AaaYi143/FPGA-Competition-Neural-Network-particle-recognition-system/stm32/verification/ui_class1_90pct.png

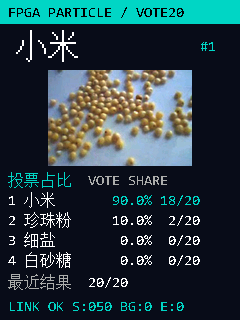
stm32/verification/ui_class1_90pct.png
