AaaYi143/FPGA-Competition-Neural-Network-particle-recognition-system/docs/视频画面参考图/ref_08_pipeline_averaging.png

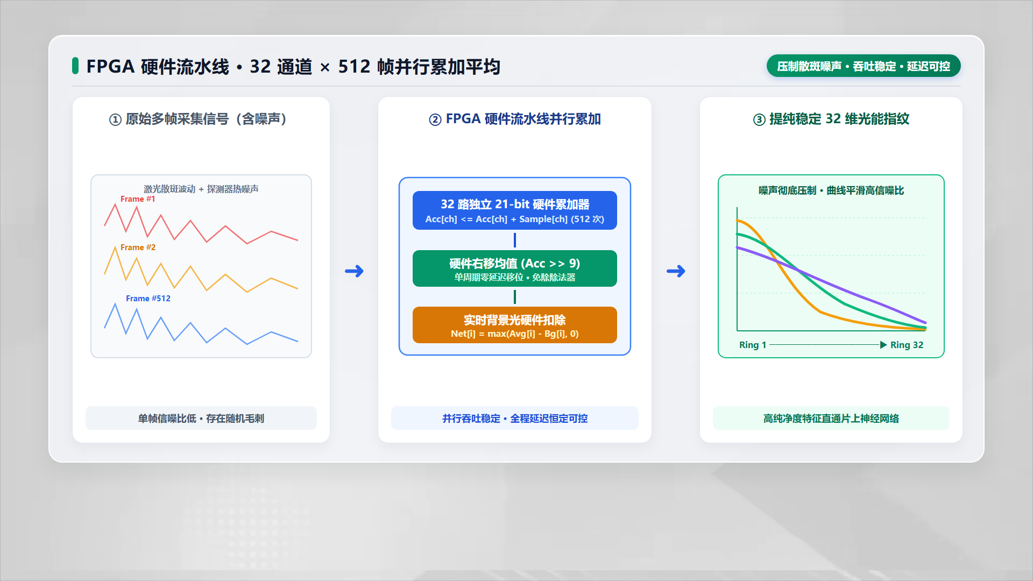
docs/视频画面参考图/ref_08_pipeline_averaging.png
