AaaYi143/FPGA-Competition-Neural-Network-particle-recognition-system/docs/design-review.md

# FPGA 激光粒度仪实施分析

截至 2026 年 9 月 7 日，已确认开发板为野火升腾 Pro XC7A100T。当前可以先完成数字采集与离线分析；老师选用的 ADC 型号、完整帧率指标、探测器实物针脚和光学标定还未提供，因此本工程当前是可验证的采集基础，尚不是可下载即测粒径的整机固件。

## 一 你现在可以承担的工作

| 工作 | 你能交付什么 | 本轮进展 | 仍需实物或老师提供 |
|---|---|---|---|
| 系统指标与分工 | 完整帧率、每环样本数、误差、延时的定义 | 本文和速率计算工具 | 明确“上万次”的单位和目标精度 |
| FPGA 扫描控制 | 4 地址线和 2 EN、互锁、稳定等待 | 已实现 | 测试点确认控制与模拟建立时间 |
| 数据组织 | 丢弃初始样本、平均、32通道快照、时间戳 | 已实现 | ADC实际位宽、数据编码 |
| ADC 驱动 | 开始转换、读回有效结果、时序约束 | 已定义适配接口 | 芯片完整型号、模块原理图与接线 |
| 上传与显示 | 正确传输整帧、画光强和粒度分布 | 离线CSV分析已实现；传输待接入 | 目标带宽、选以太网或其他出口 |
| 粒径算法 | 标定、非负正则反演、D10/D50/D90 | 算法可运行，未提供物理核 | 光学参数与标准样品实测 |
| 边缘智能 | 小模型快速估计、异常识别、质量分数 | 路线明确，未训练或部署 | 标注数据、边缘设备、误差验收标准 |
| 比赛证据 | 波形、帧率、误差和对比实验 | 验收步骤已列出 | 真实仪器测试结果 |

你最适合先把“FPGA确定性采集 + 帧数据和时间戳 + 上位机分析”做通。模拟前端、探测器针脚和光路由相关队友/老师确认，双方用明确的电压、带宽和时序接口对接。

## 二 当前设计与旧文档的差异

用户这次描述是：每一路探测器先由运放处理，再接两片 16 选 1，其公共输出进一个 ADC。旧文档描述的是 31 路半环散射探测器共用运放，另有中心透射探测器，共 32 路，且使用 FPGA 内部 XADC。旧代码甚至存在额外通道编号及特殊通道映射，不可直接复制为新硬件的环顺序。

本工程以本次描述为准。仍需要确认是 **32 个散射环**，还是 **31 个散射环 + 1 个中心透射通道**。若实际是 32 个散射环另加中心参考，总数就是 33，当前两个 16 选 1 只能覆盖 32 路，需要增加采样入口。软件默认中心是 ch0 仅沿用旧文档假设；32 路全部是散射环时，必须使用 `--center-channel none`。物理环到芯片输入的映射须逐路验证；代码只保证芯片输入顺序，不保证探测器半径顺序。

环形阵列接收角度分布并进行反演，符合激光衍射/角分辨散射的工作方式。动态光散射还需要光强随时间波动的相关分析，不能仅凭“有布朗运动”就认定为 DLS。竞赛说明应按真实测量原理修订。[激光衍射原理](https://www.malvernpanalytical.com/en/products/technology/light-scattering/laser-diffraction)、[DLS 原理](https://www.malvernpanalytical.com/en/learn/knowledge-center/technical-notes/tn101104dynamiclightscatteringintroduction)。

光路也需画清楚：典型傅里叶接收透镜是在样品散射之后将不同散射角映射到探测器半径；透镜位置不同，角度标定不同。“水珠”若指空气中的液滴，与水中悬浮颗粒的折射率和模型条件并不相同。不要直接沿用旧文档的 690 nm、焦距或 0–100 μm 范围作为实测参数。

## 三 两片模拟开关的正确控制

截图标注为 ADG1206YRUZ。按厂家真值表，EN 高有效，低电平关闭全部开关；A3..A0=0000 选择 S1，1111 选择 S16。[ADG1206 数据手册 第8–9页](https://www.analog.com/media/en/technical-documentation/data-sheets/adg1206_1207.pdf)。

| 状态 | EN1 | EN2 | A3..A0 |
|---|---|---|---|
| 上电、复位、换通道死区、故障 | 0 | 0 | 地址在全关期间更新 |
| 第一片第 k 路 | 1 | 0 | k，范围0至15 |
| 第二片第 k 路 | 0 | 1 | k，范围0至15 |
| 禁止状态 | 1 | 1 | 两路运放可能经开关互相驱动 |

四根线是通道地址线，不是四个独立片选。两片 A0 对 A0、A1 对 A1、A2 对 A2、A3 对 A3 必须实际同网。截图中的 `ADG1_LOGIC0` 和 `ADG2_LOGIC0` 名称不同，仅靠截图不能认定已连接；应统一为 `MUX_A0` 等网络，或在上层原理图明确短接，并检查导出的网表。带总线符号的线也应通过网络高亮/网表核查，不能仅凭外观判断每根支线连通。

两个 EN 应独立由 FPGA 推挽输出。关闭的一片输出明确的 0，不输出 Z。截图中的 4.7 kΩ 下拉方向符合高有效 EN 的上电关闭要求；它在 FPGA 未配置或引脚高阻时兜底。3.3 V 驱动时每根使能线的下拉电流约 0.70 mA。不要给这个型号的 EN 上拉到默认选中，也不要让 FPGA 引脚被外部上拉到 5 V。

换通道顺序：**EN全关 → 等待关断完成 → 更新共用地址 → 地址稳定 → 只开目标EN → 模拟稳定 → ADC新采样 → 丢弃/平均 → 关闭EN**。即便同一片内部有先断后通，也不等于两片芯片之间自动互锁；需要 FPGA 的全关死区。

两片 D 汇合是此架构的前提，但只在严格互斥、允许的模拟电压和充分建立时间下成立。EN 下拉只固定数字控制脚，不会把浮空的 ADC_IN 拉为零。全关期间 ADC_IN 可能保持前一次电压，不能把这段的转换当作有效值。

### 模拟电路需要核对的项目

1. 若传感器输出为光电流，前端需要跨阻放大器，反馈电阻决定 I/V 增益，反馈电容需依据光电二极管结电容与运放稳定性确定。每环先放大能避免反复切换高阻电流节点，但 32 路偏置、噪声、增益差异必须标定。
2. ADG1206 单电源工作范围包含 5 V；主要动态/导通电阻规格是在 +12 V 或双电源条件给出，不能照搬为截图 +5 V 条件下的实际指标。模拟信号要处于供电轨内。若运放用 ±12 V 而可能输出负压或超过 +5 V，必须在进入单电源开关前处理范围，不能仅在 ADC 前分压。[ADG1206 供电与规格条件](https://www.analog.com/media/en/technical-documentation/data-sheets/adg1206_1207.pdf)。
3. 共用输出的导通电阻、布线电容、ADC 采样电容和缓冲器决定建立时间。ADC 前是否需要专用缓冲取决于具体 ADC；不能默认运放可以直接驱动任意 ADC 采样网络。
4. 一阶 RC 在最坏满量程阶跃、半 LSB 误差下，理论建立时间约为 `(B+1)*ln(2)*R*C`：12位约9RC，16位约11.8RC。这只是单极点近似，还需考虑运放压摆率、多极点、开关注入和 ADC 踢回。应交替输入近零和近满量程，实测第几个采样稳定。
5. 每通道模拟滤波应与要保留的光强变化带宽匹配。扫描后共用很低截止频率的滤波器会混合前后通道，延长串扰尾巴；数字平均不能修复已混叠或已削顶的信号。
6. 若最后选 XADC，按其外部模拟输入模式及板卡接线校核范围，不能将 0–5 V 直接接进去；旧文档采用的 0–1 V 方案也须验证分压输出阻抗和采样建立。[AMD XADC 模拟输入](https://docs.amd.com/r/en-US/ug480_7Series_XADC/Analog-Inputs)。
7. 原理图截图未显示完整电源、运放、ADC和传感器连接，不能据此判定PCB可生产。EN拉低、地址默认值、去耦、共地、激光电源噪声与模拟回流都要在完整电路中核对。激光联调应使用封闭光路和终端吸光装置，避免眼睛接触直射及反射光束。

## 四 帧率预算

一帧定义为按已确定映射收集所有 32 路的有效测量值。ADC转换次数、单环更新率、完整帧率和算法输出率必须分别记录。

旧文档每通道 250 μs，整帧 `32*250 μs=8 ms`，约125帧/秒。这是原文参数的计算，不是本项目实测结果。

完整 10000 帧/秒要求每帧100 μs，每路最多3.125 μs。若每路保留N个样本、丢弃D个，粗略预算为：

`Tslot = Tbreak + Taddress + Tsettle + (D+N)/Fs_effective + Tcontrol`

`Fframe <= 1/(32*Tslot + Tframe_handshake + Toutput_stall)`

其中 Fs_effective 必须包括转换、读回及适配器吞吐约束；流水 ADC 的吞吐率和单次延时不能混用。当前核心只允许一个未完成请求，不能直接按流水 ADC 峰值吞吐计算。

| 预算条件 | 不含建立和其他开销的理论上限 |
|---|---|
| 单ADC 1MSPS，每路1个有效样本，无丢弃 | 31250帧/秒 |
| 单ADC 1MSPS，每路1有效+1丢弃 | 15625帧/秒 |
| 单ADC 1MSPS，每路4有效+1丢弃 | 6250帧/秒 |
| 单ADC 1MSPS，每路128有效，无丢弃 | 244.14帧/秒 |

XADC包含双12位1MSPS ADC，但当前两片开关并成一个模拟节点，并不能把同一单路扫描简单当作2MSPS。平均128次和完整1万帧/秒不可能在单路1MSPS条件下同时成立。[AMD XADC 概述](https://docs.amd.com/r/en-US/ug480_7Series_XADC/XADC-Overview)。

示例假设：死区0.2 μs、地址0.04 μs、建立1 μs、控制0.1 μs、1MSPS、1有效+1丢弃，则每路3.34 μs，约9356帧/秒，尚未包含输出停顿。这不是器件推荐参数或实测结果。使用 `tools/rate_budget.py` 替换参数即可重新算。

32路是顺序采样，并非同时采样。在1万帧/秒且均匀扫描时，首尾两环测量时间相差约96.875 μs。若液滴/颗粒运动比这更快，同一帧可能拼接不同状态；需要同时采样保持、多ADC并行或降低被测动态范围。FPGA流水处理不会消除这个时间偏差。

当前RTL默认参数偏保守：50MHz下死区10拍=0.2μs、地址2拍=0.04μs、稳定100拍=2μs、丢弃1次、有效1次。它们是联调起点，不保证1万帧/秒；确认实际建立时间后再调整。

### 传输带宽

按每通道16位，原始32环载荷64字节，1万帧/秒为640kB/s。若**计划**每帧增加24字节应用头和CRC，总88字节，需要880kB/s，即7.04Mbit/s应用数据；UART 8N1理论至少8.8Mbaud，还未计其他余量。115200串口最多约130.9帧/秒（88字节/帧），921600最多约1047.3帧/秒。

板载CH340是串口桥；不能把USB连接器等同于USB高速FIFO。野火Pro已有RTL8211F千兆网口，适合评估UDP分批传多帧。后续帧协议建议明确magic/version、序号、时间戳、ADC码宽、状态、饱和位图、载荷长度和CRC。UDP要记录序号缺口、乱序和溢出，不能只看界面刷新快。[本地野火规格书 第37–38、45页](<D:/vvd/A盘（资料盘）/[野火]升腾_Pro开发板硬件规格书V1.0.1.pdf>)。

当前核心为单帧握手缓冲，`frame_valid && frame_ready` 才算下游接收；等下游时不会覆盖这一帧，但会暂停开始下一帧，并累计 `stall_cycles`。因此目前不承诺采集与上传完全重叠。后续高速版应接入整帧FIFO/乒乓缓存与跨时钟FIFO，并按容量定义满时策略及丢帧计数；有限缓存不能解决长期带宽不足。

## 五 当前代码接口

`rtl/ring_scan_core.sv` 所有普通输入必须与clk同步，rst_n异步有效，实际顶层须同步释放；ADC适配器与核心一起复位。run拉低时完成当前帧再停，若要立即中断使用复位。超时进入锁定故障，EN全关，避免迟到转换进入下一环；复位前须清空ADC驱动的待完成事务。

ADC协议：`adc_req && adc_ready` 表示适配器接受一次**新的采集**，不能仅表示旧结果可读。之后至少隔一个clk边沿，用 `adc_valid` 和 `adc_data` 返回对应结果；仅一笔未完成请求。跨域多位数据用握手/FIFO，不可分别加两级同步器。

- SAR/SPI ADC：请求触发规定的CNV/CS操作，采集/转换/移位遵照型号时序，结果校正为无符号码后返回。
- 自由运行并行ADC：驱动必须清除或计数切换前已有流水样本，确定返回的是请求后的模拟输入。随便把ADC数据直接连入 `adc_valid` 会产生串环。
- XADC：需配置对应外部通道和工作模式，结合EOC与DRP的DRDY/DO读取；不能把EOC当作数据总线已有效。事件采样和连续采样的适配方式不同。当前未生成这个具体驱动。

平均按2的幂次样本数，向下截断，累加位宽随平均次数增长。`frame_data[ch*ADC_BITS +: ADC_BITS]`是该通道平均值；仅在frame_valid时整帧有效。通道0..15是第一片S1..S16，16..31是第二片S1..S16。`frame_timestamp`为开始扫描第一通道前的核心时钟计数，单位是clk周期，非UTC，也不是32路同时采样时刻；上电复位清零。`frame_id`从0开始每完成帧加1，32位自然回绕。

`frame_saturation`逐位记录保留样本出现全1码；丢弃样本不计入。此检测针对适配后无符号直二进制正满量程，不是通用的模拟削顶检测，无法检测运放提前饱和或负端削顶。默认ADC_BITS=16仅是接口占位参数；实际12位ADC应设置12并正确截取数据，而非把12位码零扩展后仍用16位满量程阈值。

## 六 反演和边缘模型怎么做

先拿可靠数据：遮光暗场 → 空白介质背景 → 已知光强/电压下的逐路增益 → 标准粒径样品验证。暗场和空白背景是不同来源的基线，最终用于程序的dark数组应匹配本次实验的校准策略。gain是校正系数，不是直接填运放增益；不同跨阻电阻应折算到一致的光强/光电流单位。必要时实测串扰矩阵，不能仅用逐路gain掩盖跨通道耦合。

物理反演需每环内外径、有效面积/角覆盖率、焦距、探测器位置、波长、介质及粒子折射率。近似theta=arctan(r/f)仅在相应光学布置成立；半环需实际角面积积分。Mie计算要将角分布按各环面积/收集立体角积分为核K，并用标准样品验证。水珠、气泡和固体颗粒不能自动共用同一核。

已实现的数值基线：先做 `y=max(raw-dark,0)*gain`，排除已确认的中心透射通道，再求 `min(x>=0) ||Kx-y||² + λ||x||²`。K必须采用与校正数据一致的单位，且列表示单位颗粒体积分数的响应；程序要求显式声明 `--kernel-basis volume_fraction`。把任意强度权重当体积分数，会导致D值含义错误。K来自外部标定或经验证的物理建模，本项目没有凭空提供K。

输出体积分布和按累积体积分数首次达到10%、50%、90%的粒径中心D10/D50/D90，离散分位受箱宽限制。残差是拟合一致性指标，不等于可信概率；低残差也不保证逆问题唯一或模型正确。32路信息不能任意支撑成百个独立粒径自由度，粒径箱数和正则强度需验证。零散射不给有效粒径；缺失核只输出光强。无信号阈值、异常残差阈值需通过真实噪声数据标定。

透射通道可以在参考强度I0存在时计算透射率/消光度，但绝对浓度还依赖光程、粒径与消光模型，不能直接把中心电压写成浓度。当前没有宣称完成浓度计量。

边缘路线建议分两层：FPGA做确定时序、统计和可量化的小模型计算；有CPU/NPU的边缘设备承担模型训练后推理或实验说明。XC7A100T是Artix-7 FPGA，不是带ARM处理系统的Zynq。大型语言模型适合低频解释、实验指导，不宜成为每一帧必须等待的闭环。

可落地的竞赛增强是用经标定的散射向量训练小MLP/查表回归，预测少量分布系数或D值，同时输出异常指标；先与上述物理基线比较，再做量化与定点误差验证。按样品批次/采集日期划分训练和测试，不能把同一段连续记录随机拆分而形成数据泄漏。测试需涵盖未见粒径、不同浓度、光源变化、气泡、污损和饱和；越界拒绝输出。没有训练数据、模型权重与独立评估时，不能说已经实现了边缘AI测量。

## 七 上板与比赛验证顺序

1. **针脚与电压**：老师确认ADC及模块原理图，测量逻辑供电、模拟输入范围、共地；核对探测器究竟是10×2还是20×2、2.0mm间距、1脚方向及各环/公共端。截图聊天对针数有矛盾，不可据此下单封装。
2. **只测数字控制**：逻辑分析仪看4地址+2EN，检查0..31循环、15→16和31→0、上电及复位关闭、任何时刻无双EN；实测死区。
3. **单ADC固定电压**：确认输入编码、零点、满量程、噪声、采样频率和读取延时；核对驱动无半字/错边沿问题。
4. **32路电压替代探测器**：各路给可区分电压，检查通道顺序，重点测试相邻0/接近满量程跳变；改变等待和丢弃次数，找满足误差预算的最短建立时间。
5. **真实暗场和空白**：记录多帧均值/标准差、工频噪声、饱和位图、各通道增益、光源漂移；报告每通道噪声而非只展示平滑曲线。
6. **完整采集上传**：记录帧号、时间戳、帧间隔分布、持续吞吐、背压/溢出、丢包。停止/重启、拔插接收端、ADC不返回都要能检测；当前数字故障逻辑已有仿真覆盖，上板仍要测。
7. **标准粒径样品**：不同已知粒径、浓度、重复测量与独立参考仪器对比，报告相对误差、重复性、有效测量范围和失败条件。不得把合成测试当实测性能图。
8. **模型对比**：同一测试集比较物理反演与模型的误差、每帧延时、持续吞吐、资源和功耗；展示异常拒绝。屏幕刷新率与内部测量帧率分开展示。

## 八 资料位置与后续对接清单

- 板卡规格书：[野火升腾Pro V1.0.1](<D:/vvd/A盘（资料盘）/[野火]升腾_Pro开发板硬件规格书V1.0.1.pdf>)，第8–9页器件，第16页时钟，第47页复位，第53–54页扩展。
- 器件 `xc7a100tfgg484-2`，50MHz时钟W19，RESET=N15。建议CN3物理5..10接A0..A3、EN1、EN2，对应Y16、AA16、AA15、AB15、U15、V15；这只是建议接线，见非激活的约束示例。
- 资料目录有AD9280/AD9708模块及 `20.dig_volt`，只是参考，不代表老师选了AD9280。
- 百/千兆以太网参考 `D:/vvd/Pro/ebf_xc7a100t_pro/ebf_xc7a100t_pro_tutorial_code_20211220/43.eth_udp_loop/`。集成时处理IP依赖、时钟域、FIFO、帧边界和网络可靠性。
- 旧 `D:/vvd/shijue/xdc/pin_constraints.xdc` 存在 `!!INVALID!!`、`!!FIXME!!` 和与正式资料冲突的时钟引脚，不应直接套用。

后续一次补充这些内容即可继续：ADC完整型号/模块正反面及原理图、接口电压和针脚；老师对完整帧率与精度的原话；探测器针脚/32通道定义；运放型号与反馈RC、输出电压范围；光学参数与标准样品；边缘计算设备。当前不等待这些信息来阻塞可独立完成的代码，但这些缺项决定了上板、真实粒径和边缘模型的最终验收。
