AaaYi143/FPGA-Competition-Neural-Network-particle-recognition-system/docs/packaging-adc-precision-review.md

# 结构、ADS8681 与电阻容差评估（2026-09-09）

本次依据用户传感器正反面照片、此前原理图截图，以及 ADS8681 官方数据手册。照片不能确定针脚定义、精确尺寸、中心探测器接法和结电容；淘宝短链未能读取，尚未验证商品模块的原理图、接口和实际性能。

## 结构决定

优先采用传感器背面直接对插的一块四层模拟前端板，板面尽量平行。通过匹配的 2.0 mm 短排母连接，使用安装孔和绝缘支柱承力，避让背面中央凸起器件，不遮挡正面光路。排针间距并不能替代排数、两组插座相对坐标和高度的实测。

| 方案 | 评价 | 使用条件 |
|---|---|---|
| 单块四层前端板 | 首选；可以把每路跨阻放大器紧靠传感器接口，调试和散热容易 | 面积允许，双面器件避让连接器和支柱 |
| 90° 运放子板 | 可以实现，但拐角连接不是屏蔽，会增加机械悬臂和连接寄生 | 若用于原始光电流，首级运放必须仍靠近连接器；更适合传送放大后的低阻输出 |
| 两三层运放板堆叠 | 暂不优先；长高阻通路、热梯度、接触可靠性、探测调试都更难控制 | 空间强制约束时，第一层完成所有跨阻转换，再按功能分层 |

建议链路：探测器 → 每路跨阻放大 → 两个 ADG1206 → ADS8681 模块 → FPGA。32 路是否包含中心通道仍待确认。

四层初步层叠可选 L1 信号/器件、L2 完整 GND、L3 尽量完整 GND、L4 信号/器件；电源在外层以短宽线或局部铜区供给，最终需按电流、布局和板厂层叠确认。若 L3 改成电源层，L4 高速信号不能跨其参考平面的分割。

优先缩短传感器引脚到反相输入及反馈环路，然后缩短复用输出到 ADC；SPI 与地址/EN 放在数字侧，避免平行贴着高阻节点。增加间距有益，但不能以绕远高阻线、扩大反馈环路或破坏地参考为代价。数字输出端可预留串联阻尼电阻，具体阻值通过边沿/振铃测试确定。地护线须有有效接地；反相输入附近的铺铜/护环按选定运放与探测器电容设计，不全面切割地平面。

## 电阻初始容差与误差预算

用户新增要求：电阻精度约 1%。本阶段将其理解为关键电阻初始容差不超过 ±1%，并不解释为粒径结果已经达到 1%。

跨阻直流增益近似 Vout=-Iphoto*Rf。22 kΩ 的 ±1% 对应 21.78–22.22 kΩ；假设相同 10 µA 光电流，稳态幅值为 217.8–222.2 mV。两路极端比值 1.01/0.99-1=2.0202%。

建议：32 路反馈电阻优先采用 0.1%、温漂不高于 25 ppm/°C 的薄膜电阻，作为工程选型目标，实际型号待 Rf、电压、功耗和封装确定。1% 反馈电阻配合逐通道标定也可做原型。25 ppm/°C 在 40°C 温差下对应约 0.1% 的单电阻变化，尚未计入初始容差、老化及自热。不要把所有上拉、下拉或数字阻尼电阻都提升到 0.1%。

反馈电阻、量程分压和增益设定属于关键电阻；EN 下拉和数字串联电阻不承担精密增益设定。逐路测暗值、用已知电流源测增益/线性，再做光学标定。均匀照明不能让不同面积的环形探测器天然产生相同电流，光学校准必须考虑有效面积与响应度。

## 原反馈网络与仿真边界

原图 Rf=22 kΩ，Cf=100 nF：时间常数 2.2 ms，反馈单极点约 72.34 Hz，理想阶跃达到 99% 约 10.13 ms。这限制光强变化的响应；32 个持续工作的独立前端仍可快速被轮询，但快速采样不能恢复被模拟低通滤掉的变化。

已生成 hardware/simulation/tia_22k_100n_tolerance.cir，三个独立通道为 Rf 标称/−1%/+1%，Cf 均为 100 nF，合成电流 0→10 µA，使用增益 1e6 的受控电压源。仅验证反馈 RC 与电阻容差，不包含真实运放带宽、相位、噪声、偏置、摆率、电源饱和、传感器结电容或多路复用器寄生，不能用其判断 OP37 稳定性或实机精度。

下一阶段应使用真实运放宏模型，加上各环光电流范围、结电容与连接寄生，进行 DC/AC/瞬态/噪声/容差分析；接着测试最大通道跳变下的复用建立时间。OP37 是非单位增益稳定器件，必须核查跨阻电路的噪声增益与环路稳定性。未知参数可以做敏感性扫描，但必须明确它们不是实测值。

本机 Multisim 已完成上述简化模型的 0–30 ms 三路瞬态运行，并保存 .ms14 工程和 .gra 曲线。曲线呈现约0.22 V幅值和毫秒级响应，但导入后输出极性与原 SPICE 网表预期相反，尚需核对源映射；本次未通过极性验证，不能据此签署原理图正确或 OP37 稳定性合格。详情见 hardware/simulation/README.md。

## ADS8681 接口和速率

芯片为单通道 16 位、最高 1 MSPS，集成模拟前端和可编程单双极性量程，输入阻抗至少 1 MΩ。无需仅因为它是 SAR ADC 就认定必须外加高速 ADC 驱动运放；是否需要缓冲/RC 由复用器源阻抗、模块输入网络和建立误差决定。

ADS8681 能接受的电压范围不能替代 ADG1206 的信号范围。此前运放 ±12 V、复用器 ±5 V 的方案仍需核查过量程和上电过程。模块供电 5 V 不等于 FPGA 接口一定为 3.3 V；确认 DVDD/电平转换，以及 CONVST/CS、SCLK、SDI、SDO、RVS、RESET 的实际引出。

32 路、每路保留一次、无额外开销，理想上限 1e6/32=31250 完整帧/秒；若每路先丢弃一次再保留一次则为15625帧/秒。实际需计入复用死区、建立、转换、SPI读取及传输开销，不能承诺达到此上限。目标10000帧/秒意味着每通道总预算3.125 µs。丢弃首样本仅在时序验证有需要时启用，不能替代建立时间计算。

## 原理图工具

本项目建议继续使用嘉立创 EDA 专业版，沿用现有工程和团队器件库。KiCad 适合新项目、文本版本管理和脚本化审查，但迁移会产生封装、网络名和库映射核查成本。AD 适合已有授权、成熟库和熟悉流程的团队；不会单凭换软件改善模拟性能。Multisim 负责电路模型验证，PCB 最终还需 ERC/DRC、封装/连接器核对、布局检查和实测。

## 资料来源

- TI ADS8681 数据手册：https://www.ti.com/lit/ds/symlink/ads8681.pdf
- ADI OP37 数据手册：https://www.analog.com/media/en/technical-documentation/data-sheets/OP37.pdf
- Vishay 精密薄膜电阻产品示例：https://www.vishay.com/en/product/60057/
- NI SPICE 模型兼容性：https://knowledge.ni.com/KnowledgeArticleDetails?id=kA00Z0000019NoBSAU&l=en-US

设计定值仍需：探测器针脚表/尺寸/光电流及结电容；ADC 模块原理图、接口照片和模块尺寸；目标完整帧率及实际信号带宽。
