AaaYi143/FPGA-Competition-Neural-Network-particle-recognition-system/docs/字幕.md

**【00:00‑00:20 结论先行】**

我们带来一套基于 32 环光能阵列与 FPGA 的激光颗粒智能识别系统。系统依托确定性延迟采集、硬件流水线累计平均与片上神经网络推理三大核心能力，在无需上位机参与运算的条件下，实时准确地识别多种颗粒，并能够分辨肉眼无法区分的粉体样品。

**【00:20‑00:55 实测效果展示】**

接下来开展实测验证。在空白无样品条件下，系统正确识别背景状态。随后依次放入食盐、白砂糖、小米颗粒，屏幕实时呈现分类结果。最后展示的两种玻璃微珠粒径不同、肉眼几乎无法区分，系统依然依靠各自独特的光能散射指纹，稳定准确地完成区分，这一结果直观展现了系统在肉眼辨识极限之外的识别能力。

**【00:55‑01:10 光路与散射光场生成】**

激光经准直后照射颗粒样品，颗粒向空间各个方向散射光线。粒径与折射率不同，散射光强与角度分布随之改变，在空间中形成各自独一无二的散射光场。

**【01:10‑01:50 32 环光能指纹与神经网络引入】**

系统基于静态光散射原理搭建。32 环环形光电探测阵列从 32 个角度采集散射光强，每一类颗粒对应一条专属的 32 维光能散射指纹。粒径、折射率与散射光强之间呈现复杂的非线性映射关系，简单阈值判断难以覆盖全部颗粒类型。系统将 32 维光能指纹送入轻量化神经网络，由 FPGA 在片上完成推理，将指纹直接映射至颗粒类别。系统采集空白、食盐、白砂糖、小米以及两种玻璃微珠的样本数据集，完成模型训练与量化，并将网络部署至 FPGA 内部。

**【01:50‑02:35 FPGA 核心工程实现】**

FPGA 作为整套系统的硬件核心，依次完成整条链路处理。硬件时序直接驱动 32 环通道采集，纯硬件逻辑不存在操作系统带来的随机抖动，每一轮 32 环采集时序精准对齐，为后续累计平均提供可靠的数据基础。系统在 FPGA 内搭建硬件流水线，对多组采集数据持续累加平均，有效压制采集噪声，提纯稳定的 32 维光能散射指纹，大量重复运算并行执行，吞吐稳定、全程延迟可控。经累计平均提纯后的 32 维光能特征随即送入量化神经网络，在 FPGA 内部实时完成分类推理。从信号采集、累计平均到神经网络分类，整条链路全部在 FPGA 端完成，无需上位机参与运算。

**【02:35‑03:00 价值与应用拓展】**

这套方案不仅适用于当前演示的颗粒样品，同时具备良好的拓展能力。系统可进一步识别更多超细粉体，适用于工业粉体质控、材料筛分与食品颗粒检测等场景，为小型化、嵌入式激光智能粒度检测提供一套完整的全硬件解决方案。

**【03:00‑03:20 结尾总结】**

本项目以 FPGA 为硬件核心，实现确定性时序采集、硬件流水线海量累计平均与片上神经网络加速，能够稳定区分肉眼难以分辨的粉体样品，为小型化、嵌入式、全硬件化的在线激光颗粒识别提供一套完整可行的方案。
