AaaYi143/FPGA-Competition-Neural-Network-particle-recognition-system/3D models/delivery/previews/P01.png

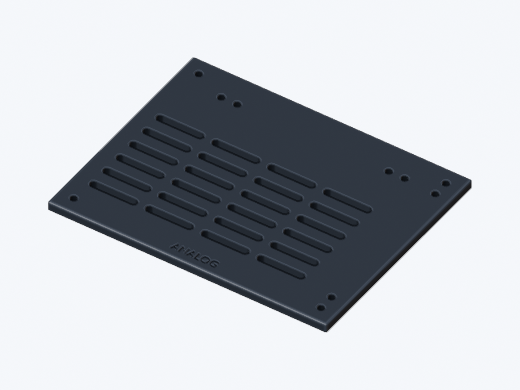
3D models/delivery/previews/P01.png
