AaaYi143/FPGA-Competition-Neural-Network-particle-recognition-system/3D models/delivery/previews/P02.png

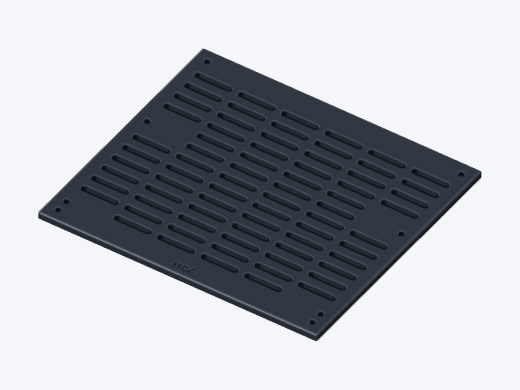
3D models/delivery/previews/P02.png
