AaaYi143/FPGA-Competition-Neural-Network-particle-recognition-system/3D models/delivery/previews/P07.png

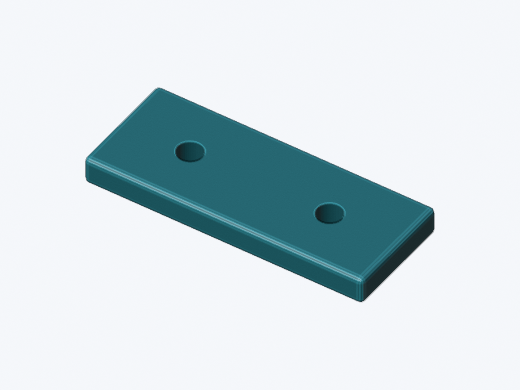
3D models/delivery/previews/P07.png
