AaaYi143/FPGA-Competition-Neural-Network-particle-recognition-system/3D models/delivery/previews/structure.png

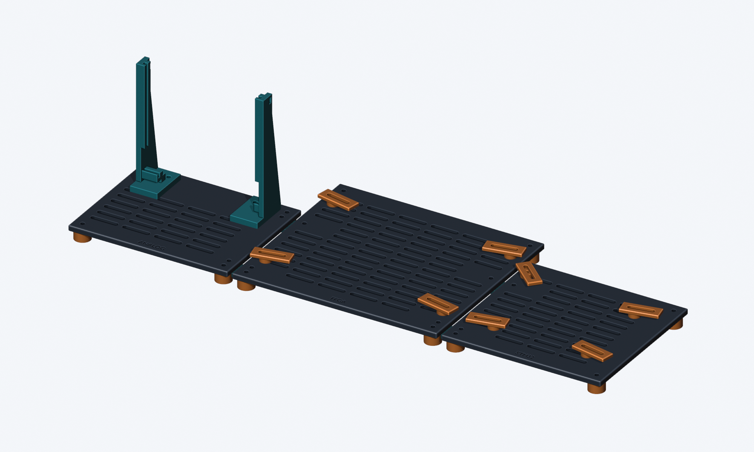
3D models/delivery/previews/structure.png
