AaaYi143/FPGA-Competition-Neural-Network-particle-recognition-system/docs/视频画面参考图/07_01m28s-01m43s_FPGA纯硬件确定性时序采集.png

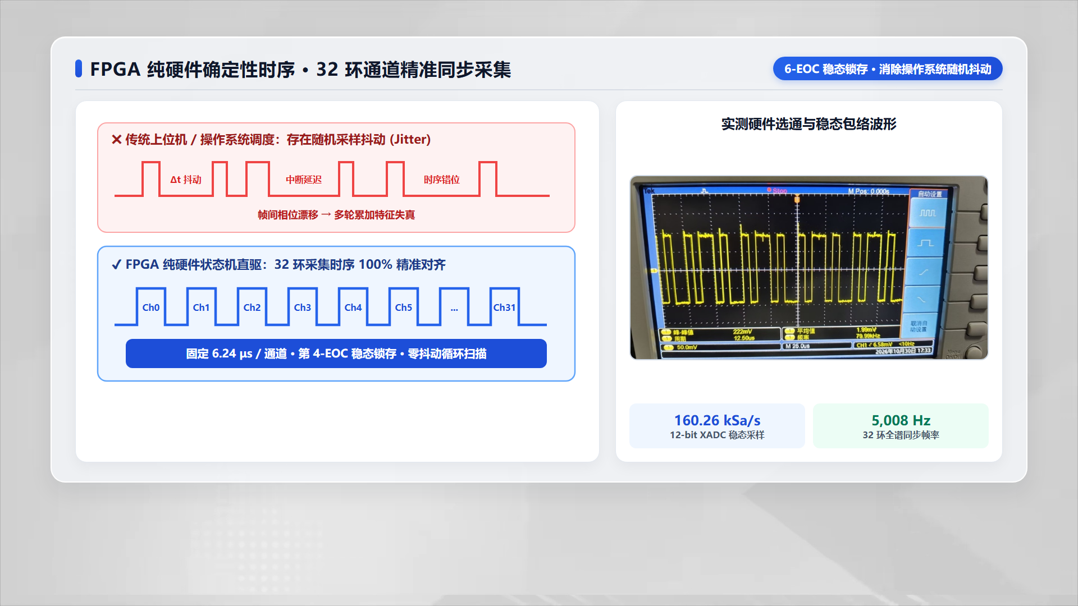
docs/视频画面参考图/07_01m28s-01m43s_FPGA纯硬件确定性时序采集.png
