AaaYi143/FPGA-Competition-Neural-Network-particle-recognition-system/docs/视频画面参考图/10_02m07s-02m23s_FPGA资源利用率与扩展空间.png

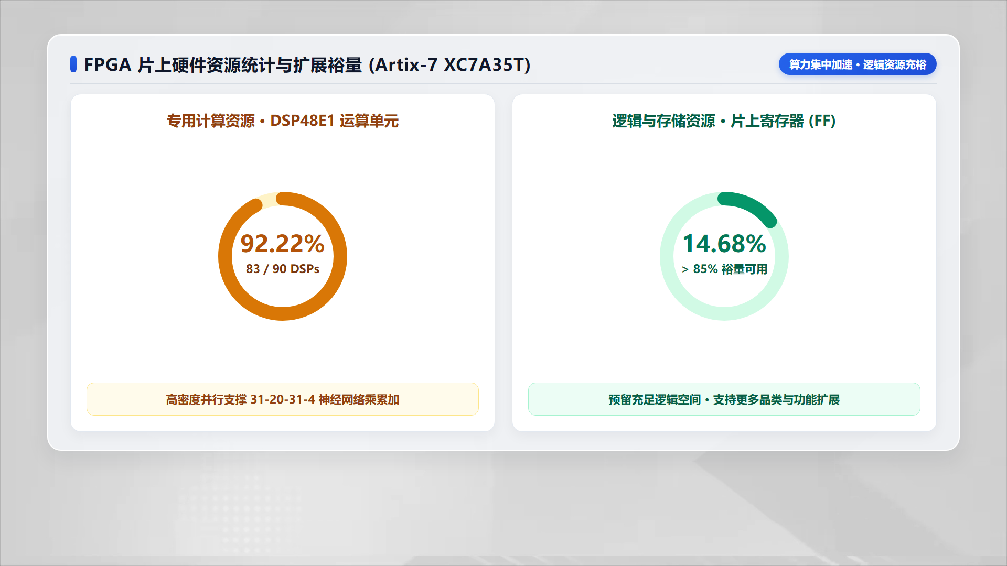
docs/视频画面参考图/10_02m07s-02m23s_FPGA资源利用率与扩展空间.png
