AaaYi143/FPGA-Competition-Neural-Network-particle-recognition-system/docs/视频画面参考图/ref_04_32ring_to_nn.png

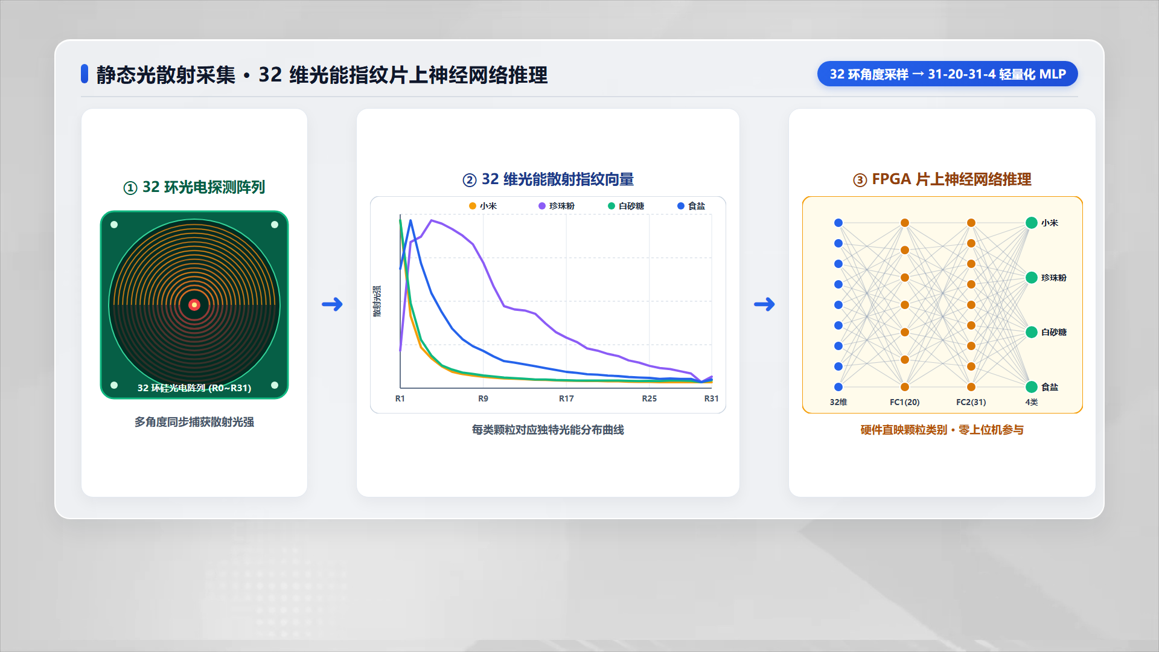
docs/视频画面参考图/ref_04_32ring_to_nn.png
