AaaYi143/FPGA-Competition-Neural-Network-particle-recognition-system/docs/视频画面参考图/ref_11_application_expansion.png

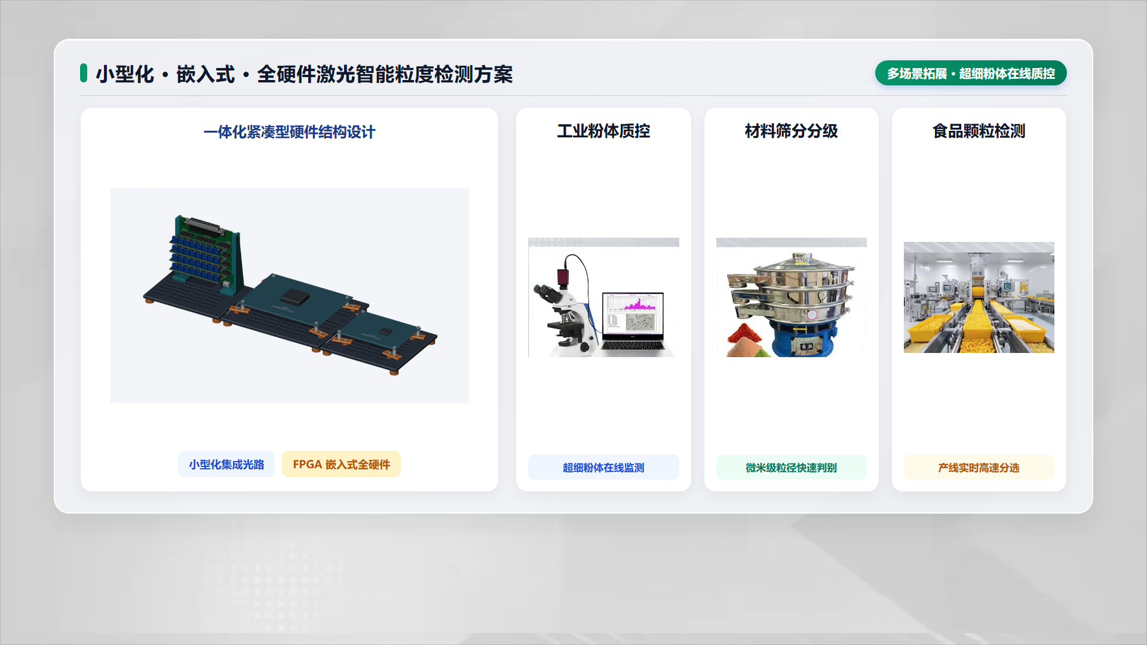
docs/视频画面参考图/ref_11_application_expansion.png
