AaaYi143/FPGA-Competition-Neural-Network-particle-recognition-system/metrics/evidence/1a8b46acd04a6e1159901d2c1986781a.jpg

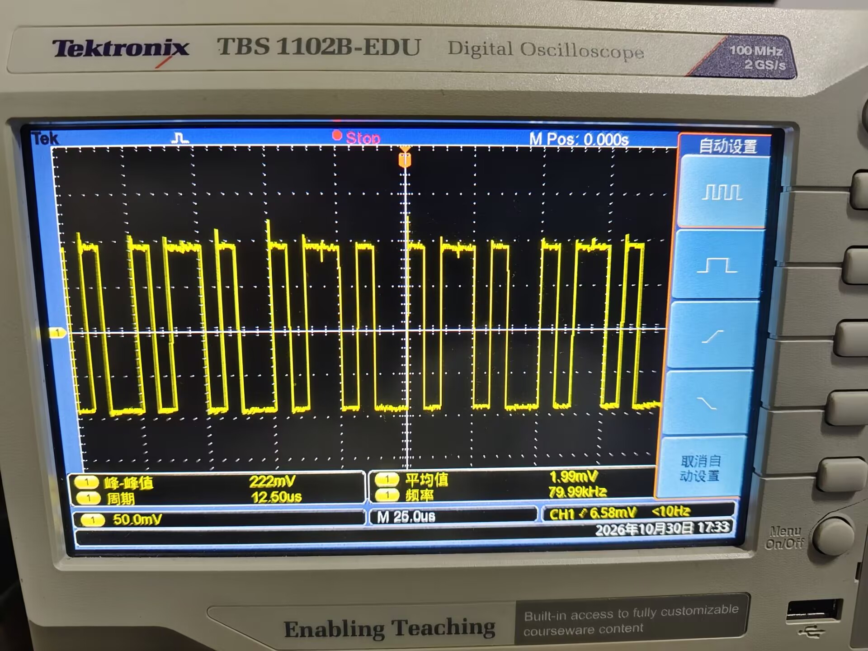
metrics/evidence/1a8b46acd04a6e1159901d2c1986781a.jpg
