AaaYi143/FPGA-Competition-Neural-Network-particle-recognition-system/metrics/evidence/52b22c45d04e7f41cf6d69bf0d3206c7.png

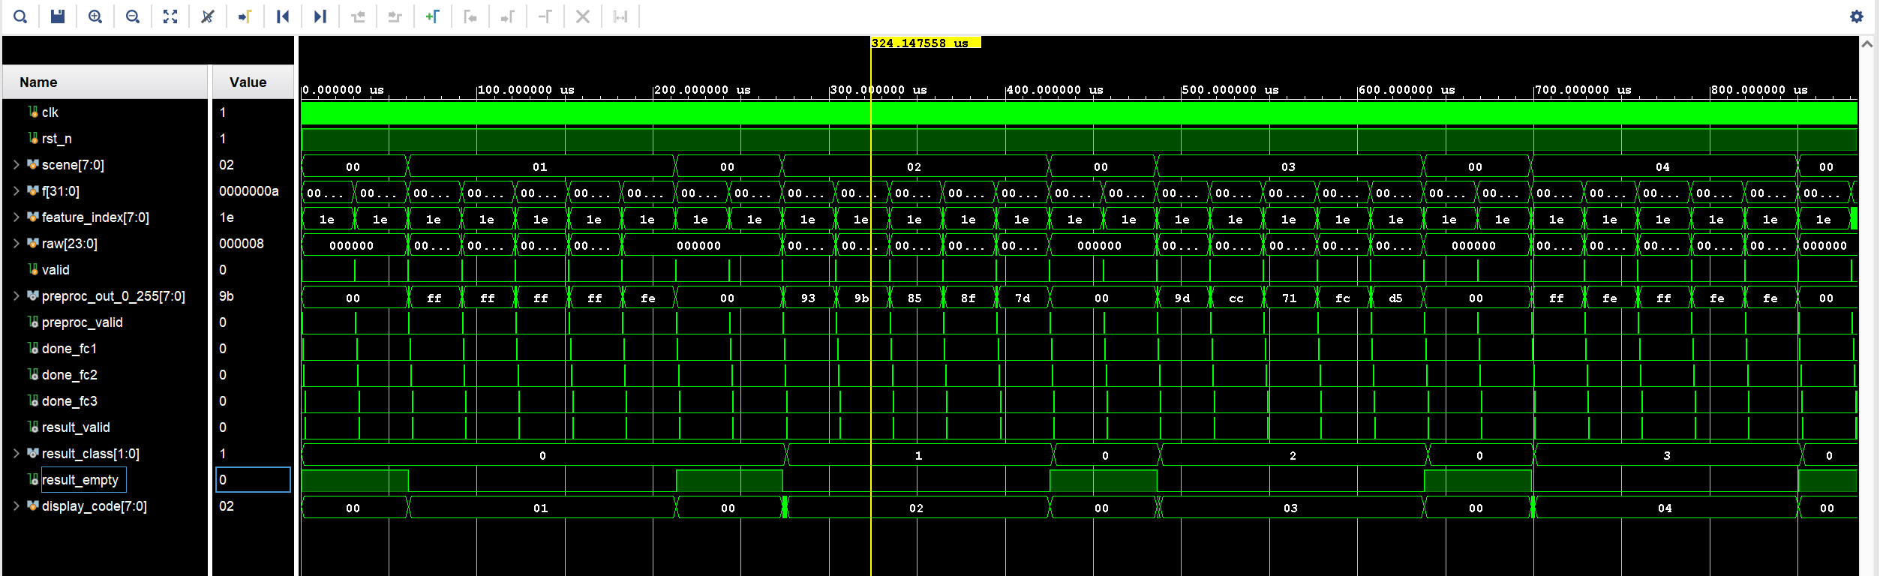
metrics/evidence/52b22c45d04e7f41cf6d69bf0d3206c7.png
