AaaYi143/FPGA-Competition-Neural-Network-particle-recognition-system/metrics/evidence/bca0cf5ff4689c3482fdfc5c6a3cb0f0.png

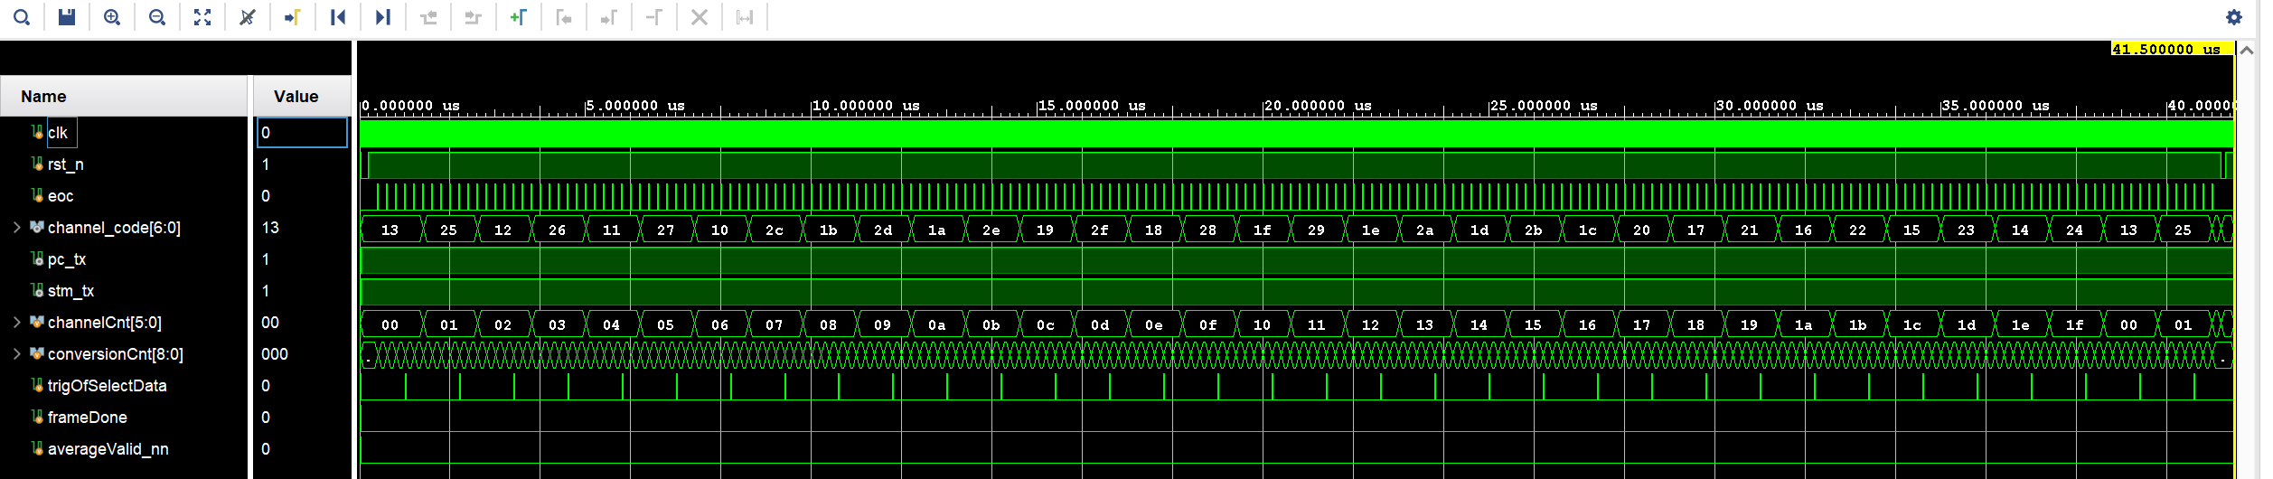
metrics/evidence/bca0cf5ff4689c3482fdfc5c6a3cb0f0.png
