AaaYi143/FPGA-Competition-Neural-Network-particle-recognition-system/metrics/evidence/示波器.png

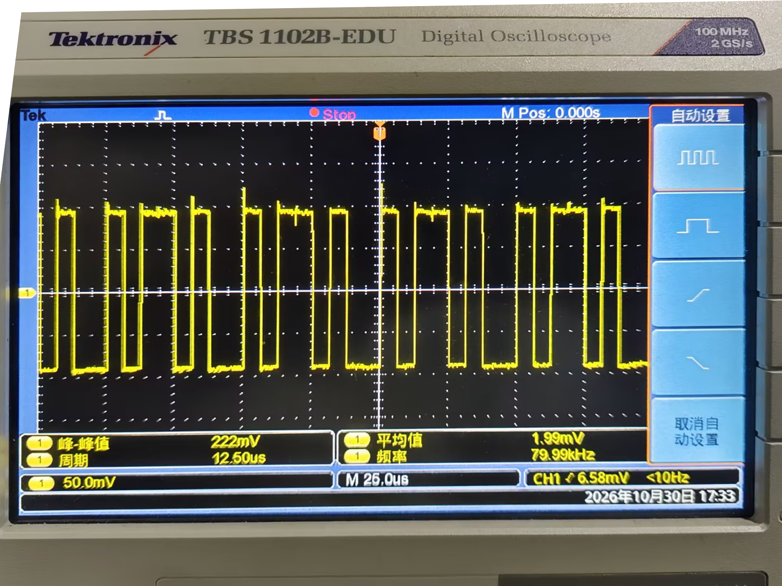
metrics/evidence/示波器.png
