AaaYi143/FPGA-Competition-Neural-Network-particle-recognition-system/3D models/delivery/stl/P06_FPGA_slider_1.stl

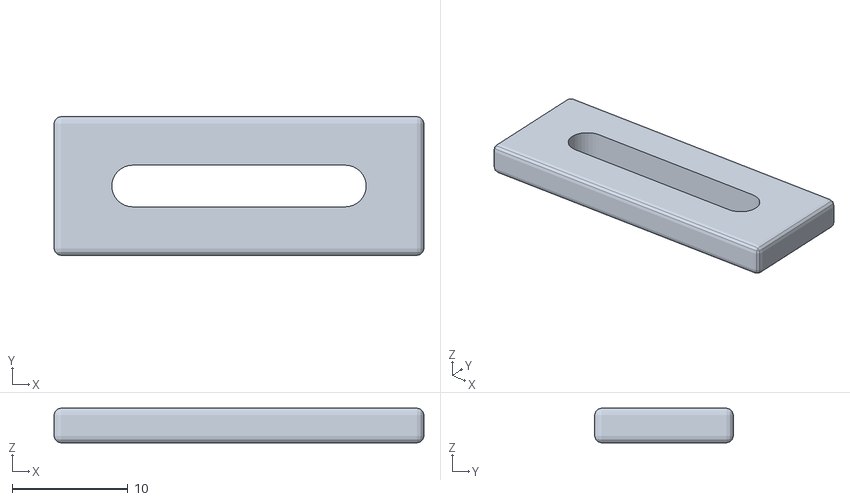
[picture p30: CAD file, 2026-11-03]
3D models/delivery/stl/P06_FPGA_slider_1.stl
32.0 x 12.0 x 3.00
