AaaYi143/FPGA-Competition-Neural-Network-particle-recognition-system/3D models/一体式/卡槽.stl

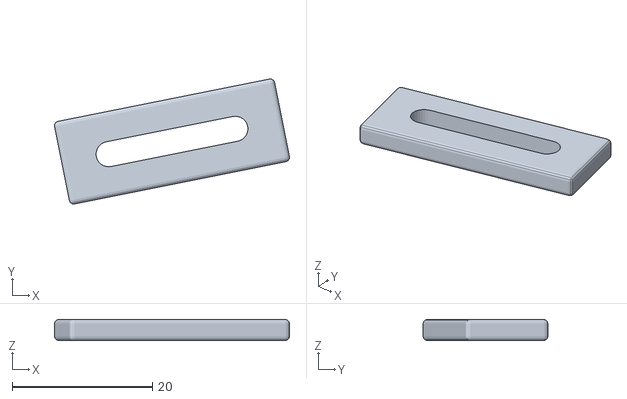
[picture p31: CAD file, 2026-11-03]
3D models/一体式/卡槽.stl
33.5 x 17.8 x 3.00
