AaaYi143/FPGA-Competition-Neural-Network-particle-recognition-system/3D models/delivery/stl/P04_analog_left.stl

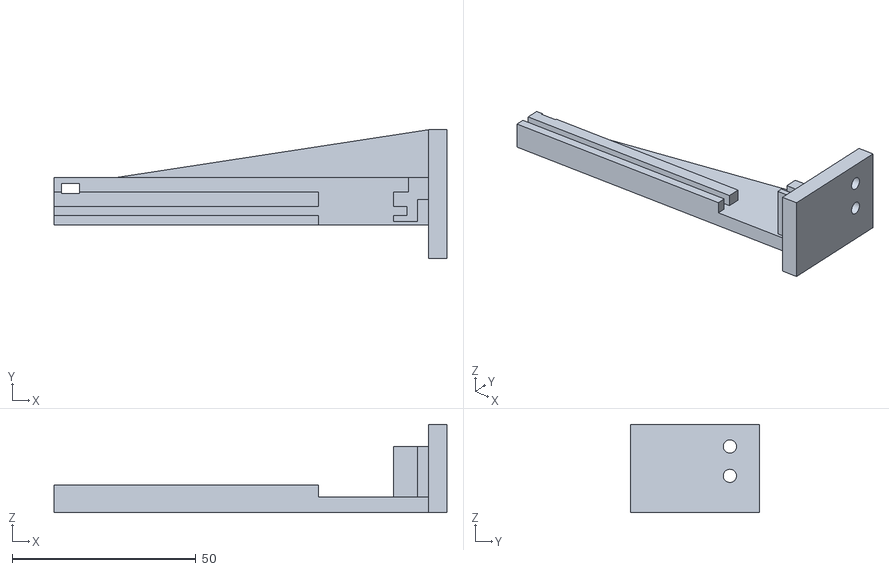
[picture p32: CAD file, 2026-11-03]
3D models/delivery/stl/P04_analog_left.stl
107.0 x 35.0 x 24.0
