AaaYi143/FPGA-Competition-Neural-Network-particle-recognition-system/3D models/一体式/支撑柱大.stl

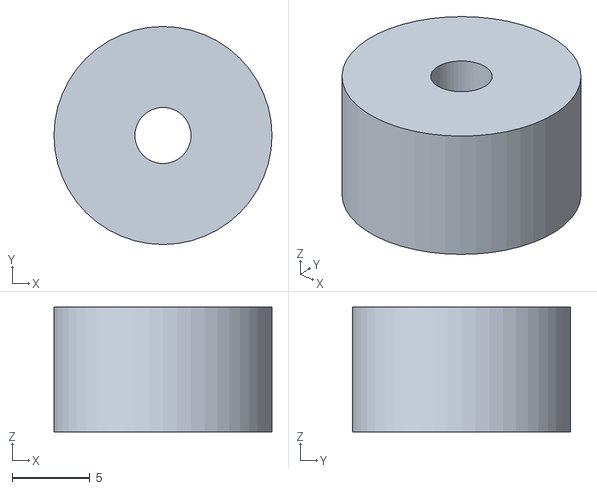
[picture p33: CAD file, 2026-11-03]
3D models/一体式/支撑柱大.stl
14.0 x 14.0 x 8.00
