AaaYi143/FPGA-Competition-Neural-Network-particle-recognition-system/3D models/delivery/stl/P02_FPGA_base.stl

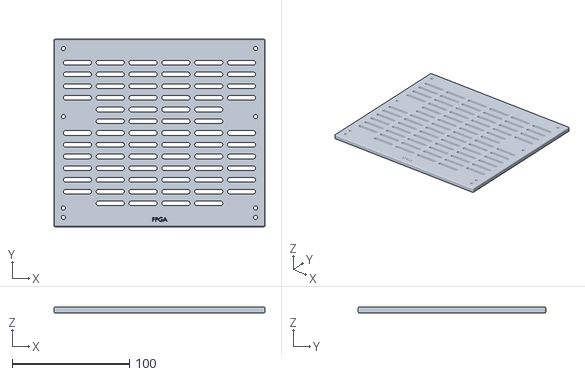
[picture p34: CAD file, 2026-11-03]
3D models/delivery/stl/P02_FPGA_base.stl
180.0 x 160.0 x 5.00
