AaaYi143/FPGA-Competition-Neural-Network-particle-recognition-system/3D models/一体式/支撑柱小.stl

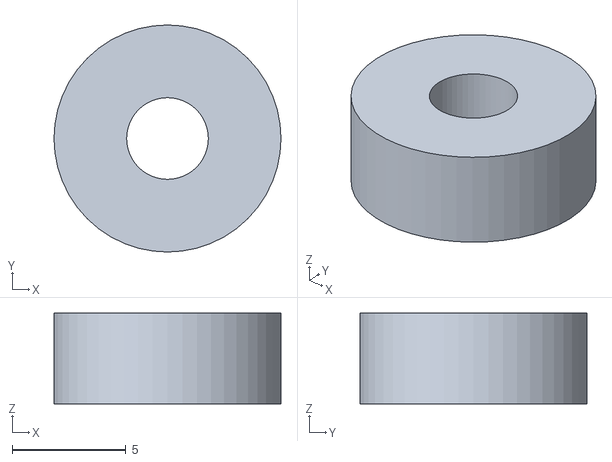
[picture p35: CAD file, 2026-11-03]
3D models/一体式/支撑柱小.stl
10.0 x 10.0 x 4.00
