AaaYi143/FPGA-Competition-Neural-Network-particle-recognition-system/3D models/一体式/运放右支撑.stl

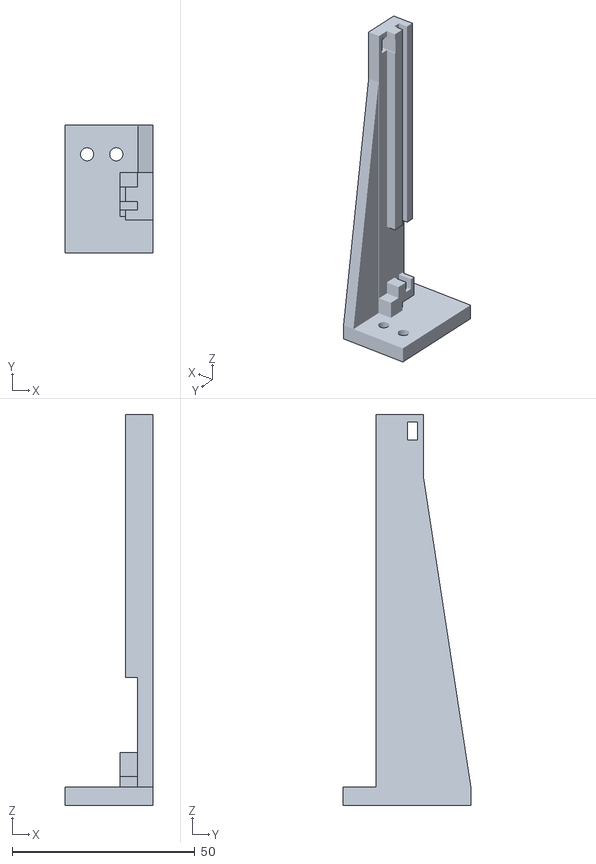
[picture p36: CAD file, 2026-11-03]
3D models/一体式/运放右支撑.stl
24.0 x 35.0 x 107.0
