AaaYi143/FPGA-Competition-Neural-Network-particle-recognition-system/(list of files, cad)

Other CAD files:
3D models/一体式/FPGA.stl
3D models/delivery/FPGA_STM32_Rack.blend
