AaaYi143/FPGA-Competition-Neural-Network-particle-recognition-system/metrics/scrips/stm32_flash/requirements-installed.txt

appdirs==1.4.4
capstone==5.0.9
cffi==2.1.1
cmsis-pack-manager==0.6.0
colorama==0.4.6
hidapi==0.15.0
importlib_metadata==9.0.1
importlib_resources==7.1.0
intelhex==2.3.0
intervaltree==3.2.1
lark==1.3.1
libusb-package==1.0.30.0
natsort==8.4.0
prettytable==3.18.0
psutil==7.2.2
pycparser==3.11
pyelftools==0.33
pylink-square==1.7.0
pyocd==0.46.0
pyusb==1.3.1
PyYAML==6.0.3
six==1.17.0
sortedcontainers==2.4.0
typing_extensions==4.16.0
wcwidth==0.9.3
zipp==4.1.2
