AaaYi143/FPGA-Competition-Neural-Network-particle-recognition-system/docs/validation.md

# 本轮验证记录

验证日期：2026-09-07。此记录仅描述真实执行的软件/RTL验证，不是激光粒度仪的实测性能报告。

## RTL 功能仿真

命令：`scripts/run_sim.ps1`，实际工具Vivado Simulator 2018.3，最终退出码0，打印 `ALL TESTS PASSED`。

两个并行测试实例均为12位模拟ADC：平均4次并丢弃1次；平均1次且不丢弃。测试台采用100MHz逻辑时钟加速数字事件检查，模拟ADC响应延迟人为变化；这不表示真实ADC吞吐或模拟建立时间已验证。核心目标板时钟仍为50MHz。

已检查全部32通道顺序、EN全程互斥、地址只在全关死区之后更新、地址稳定时间、使能后等待、初始污染样本丢弃、整数平均（含末通道全满量程防溢出）、有效样本饱和位图、可变request-ready/response延迟、整帧背压下数据和元数据保持、停机时完成当前帧、序号和时间戳递增、转换途中复位、请求超时、响应超时、迟到响应不解除故障、复位后恢复。

原始日志：`build/sim/simulation.log`。最终仿真完成时间52692ns。

## 综合与资源

命令：`scripts/run_synth.ps1`，实际工具Vivado2018.3，目标 `xc7a100tfgg484-2`，out-of-context模式，使用RTL默认参数（16位接口、平均1次、丢弃1次）。最终退出码0，DCP和报告均已生成。

| 项目 | 本轮综合结果 |
|---|---|
| Slice LUT | 291，占0.46% |
| Slice寄存器 | 866，占0.68% |
| Latch | 0 |
| DSP | 0 |
| Block RAM Tile | 0 |
| 20ns时钟下综合后内部WNS | +16.232ns |

报告 `build/synth/utilization.rpt`、`build/synth/timing.rpt`；检查点 `build/synth/ring_scan_core.dcp`。寄存器用于帧快照、计数与状态，不表示完整系统资源。

**时序范围**：只约束20ns核心时钟，21个输入端口和687个输出端口尚无板级I/O延迟，OOC端口未设置实际时钟缓冲位置，工具对时钟延迟/偏斜估算给出提示。未布局布线、未闭合外部接口时序，WNS不能解读为真实板卡可达最高频率。综合阶段零RTL错误/警告；随后网表有平面层级floorplanning建议，时序阶段有上述OOC时钟提示，均未隐藏。

运行环境说明：沙箱内首次综合在旧版Vivado清理临时目录时失败；普通Windows权限重跑同一源文件成功，并保存报告。没有忽略失败后继续生成虚假成功记录，也没有烧写开发板。

## Python 分析

使用本机bundled Python与NumPy，执行 `-m unittest discover -s tests -v`，**11项测试全部通过**，含：

- 暗场/增益校正和负值裁剪、空数据/通道数/非法校准。
- 中心通道排除或全部32散射通道、零光时不提供有效粒径。
- 已知代数解、正则化和非负边界、体积CDF分位数。
- 12组随机小问题与穷举全部活动子集的独立最优值对照。
- 非法光学核、64位时间戳保存、demo CLI。
- 仅在明确ADC最大码时检查饱和，区分中心饱和和散射饱和。

已运行20帧合成示例，输出在 `build/demo/SYNTHETIC_demo_corrected.csv` 与 `build/demo/SYNTHETIC_demo_summary.json`。示例没有物理核或粒径输出；不能将其作为比赛实测数据。

## 速率预算检查

执行 `tools/rate_budget.py --adc-sps 1000000 --settle-us 1`，按默认其余假设得到每路3.34μs、输出停顿前约9356.29帧/秒；10000帧/秒所需每路预算3.125μs，因此余量不足。88字节应用帧对应UART 8N1至少8.8Mbaud。数字均为明确假设的计算结果。

## 未完成的实物验收

ADC驱动及编码、电压与通道针脚、模拟稳定时间/串扰/噪声、物理顶层和I/O约束、上传接口/FIFO/CDC、连续完整帧率、标准粒径校准、浓度模型、真实训练数据及边缘推理均未验证。没有生成bitstream，没有连接/烧录板卡，也没有报告实测粒径或1万帧/秒已实现。
