AaaYi143/FPGA-Competition-Neural-Network-particle-recognition-system/metrics/scrips/v3_csv_capture/VALIDATION.md

# 本次验证

2026-10-18已切换队友版注册表，重新实际执行8项测试全部通过，界面启动检查输出 CURRENT_CAPTURE_GUI_PASS。CSV固件标记为teammate_20261018，可疑位置0、1号；既有CSV未改写。以下保留最初交付时的验证记录。

2026-10-16，本机既有 Windows Python 环境安装 pyserial 3.5。

实际执行 `python -m pytest tools/v3_csv_capture/test_capture.py -q --tb=short`：**8 passed**。
范围包含：任意字节分段、小端32路值保留、帧尾分段、错长/超范围/丢字节后重同步、缓冲区上限、中文CSV往返、仅删除本工具CSV、启动丢弃、假串口关闭、端口打开失败。

实际执行隐藏窗口启动检查 `capture.main(smoke=True)`：**GUI_SMOKE_PASS**。该检查创建并关闭Tk界面，仅枚举串口，不打开串口。

首次测试因沙箱默认pytest临时目录不可写导致5项夹具错误、3项通过；测试夹具改为在本工具的独立工作区临时目录中执行并清理，随后8项全部通过。没有通过放宽采集数据校验使测试通过。

未打开COM10或其他真实串口，未采集实板数据，未烧录或修改v3 BIT。本次测试不证明实板链路、光学样品标签或增益设置正确。当前v3协议没有CRC/设备帧序号，因此完整性检查仅限帧结构和码值范围。
