AaaYi143/FPGA-Competition-Neural-Network-particle-recognition-system/stm32/verification/ui_boot.png

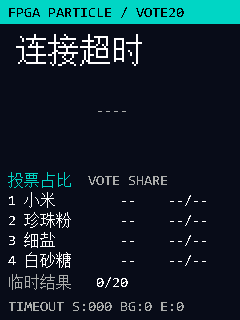
stm32/verification/ui_boot.png
