AaaYi143/FPGA-Competition-Neural-Network-particle-recognition-system/stm32/verification/ui_class4_warmup.png

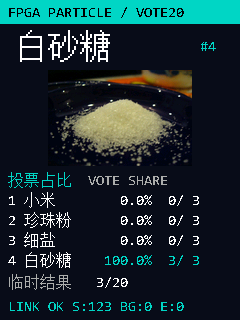
stm32/verification/ui_class4_warmup.png
