AaaYi143/FPGA-Competition-Neural-Network-particle-recognition-system/(notices)

Notices in the files:
README.md:
License: Academic/Competition
